Dong-quan/Kicad_BLDC_Motor/Doan2.step

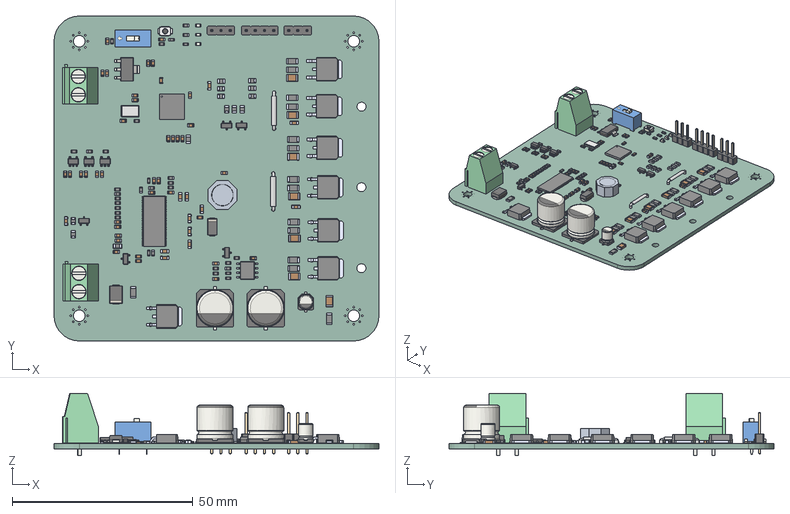
[picture p6: CAD file, 2026-10-30]
Doan2.step
90.0 x 90.0 x 17.3 mm
C_0805 x 12
IRFR7440PBF x 7
C_0603 x 38
R_1206 x 14
CP_Elec_4x5.4
R_0603 x 32
Crystal_4_5032
C_1206 x 7
R_0805 x 11
SOT-223
Bead_Ferrite_0805 x 2
SOT-23-3 x 5
SOT-23-5 x 3
L_8043
PinHeader_1x03_P2.54mm_Vertical x 2
TerminalBlock_Phoenix_MKDS-1,5-2-5.08_1x02_P5.08mm_Horizontal x 2
Shunt_1m x 2
CP_Elec_10x10.5 x 2
LED_0603_1608Metric x 3
STM32G431CBU6
SW_SPST_B3U-1000P
D_SMB
DRV8302DCA
MCP6002-I_SN
SW_DIP_SPSTx01_Slide_9.78x4.72mm_W7.62mm_P2.54mm
PinHeader_1x04_P2.54mm_Vertical
D_SMA
Doan2_PCB
