Dong-quan/Kicad_BLDC_Motor/Doan2.kicad_sch

## KiCad design Doan2.kicad_sch (2026-10-30)

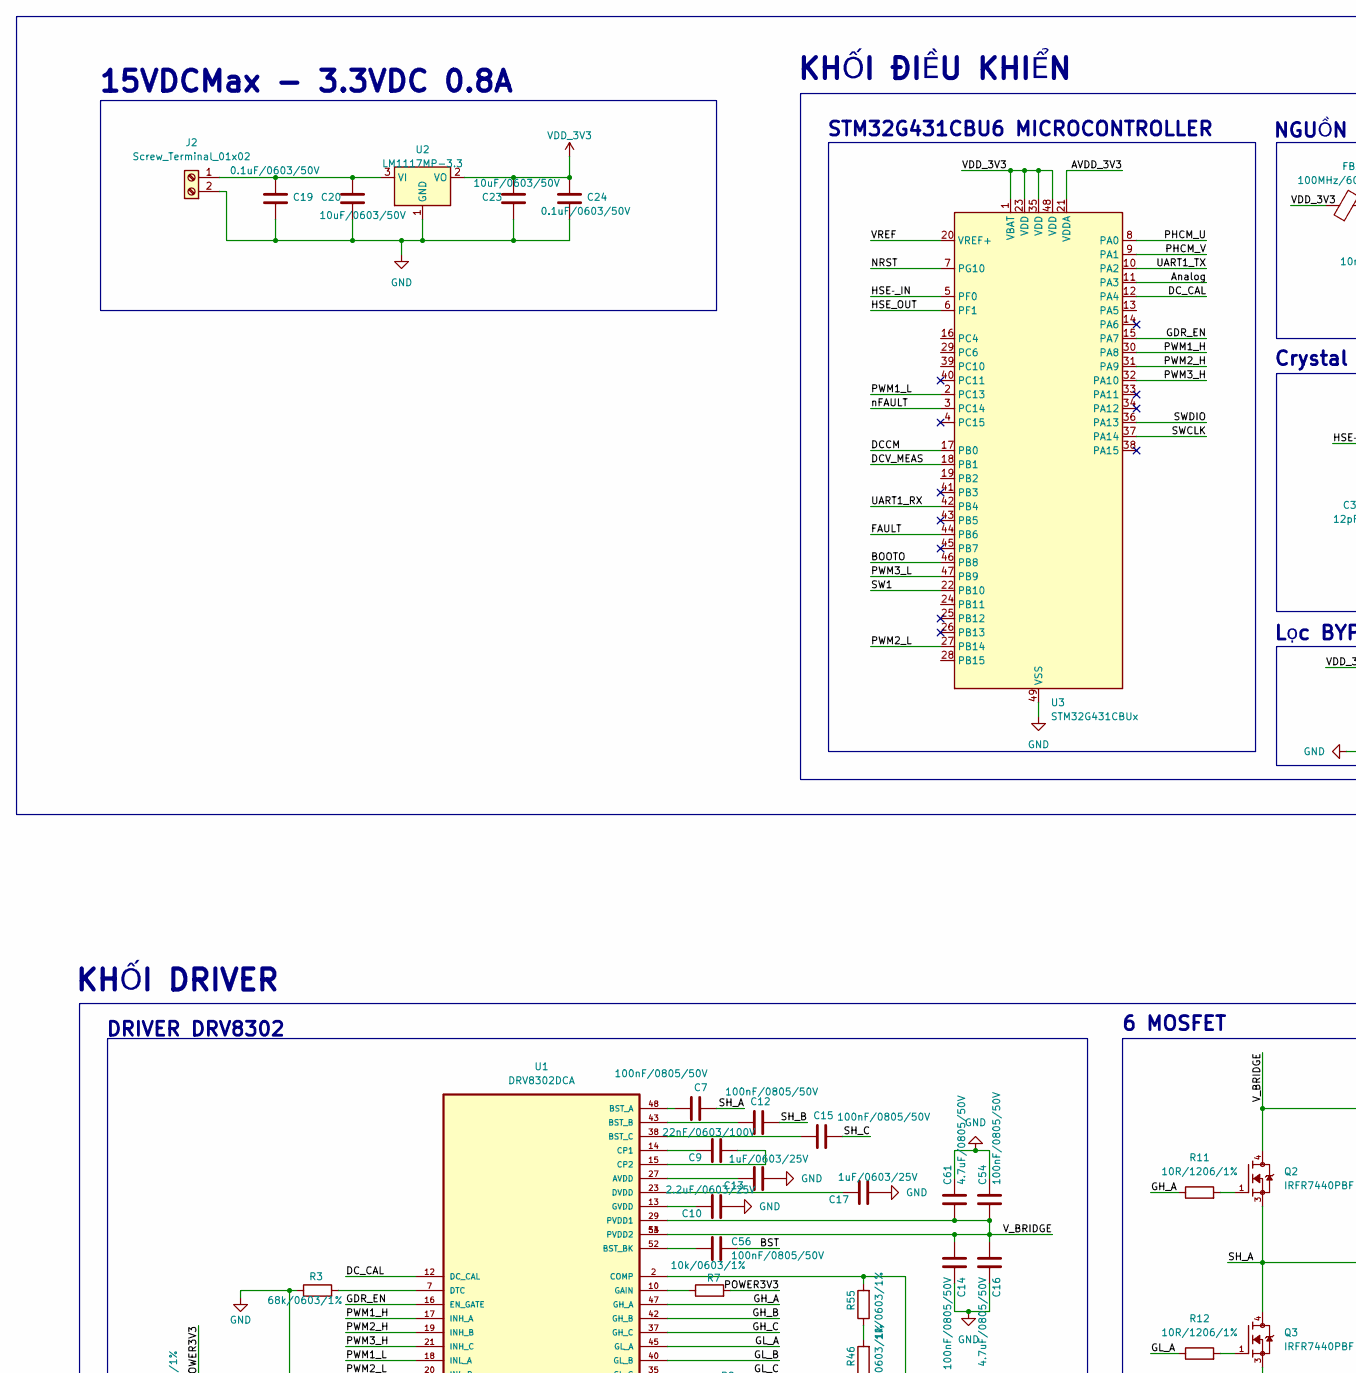
[picture p7: schematic Doan2.kicad_sch, part in row 1, column 1]

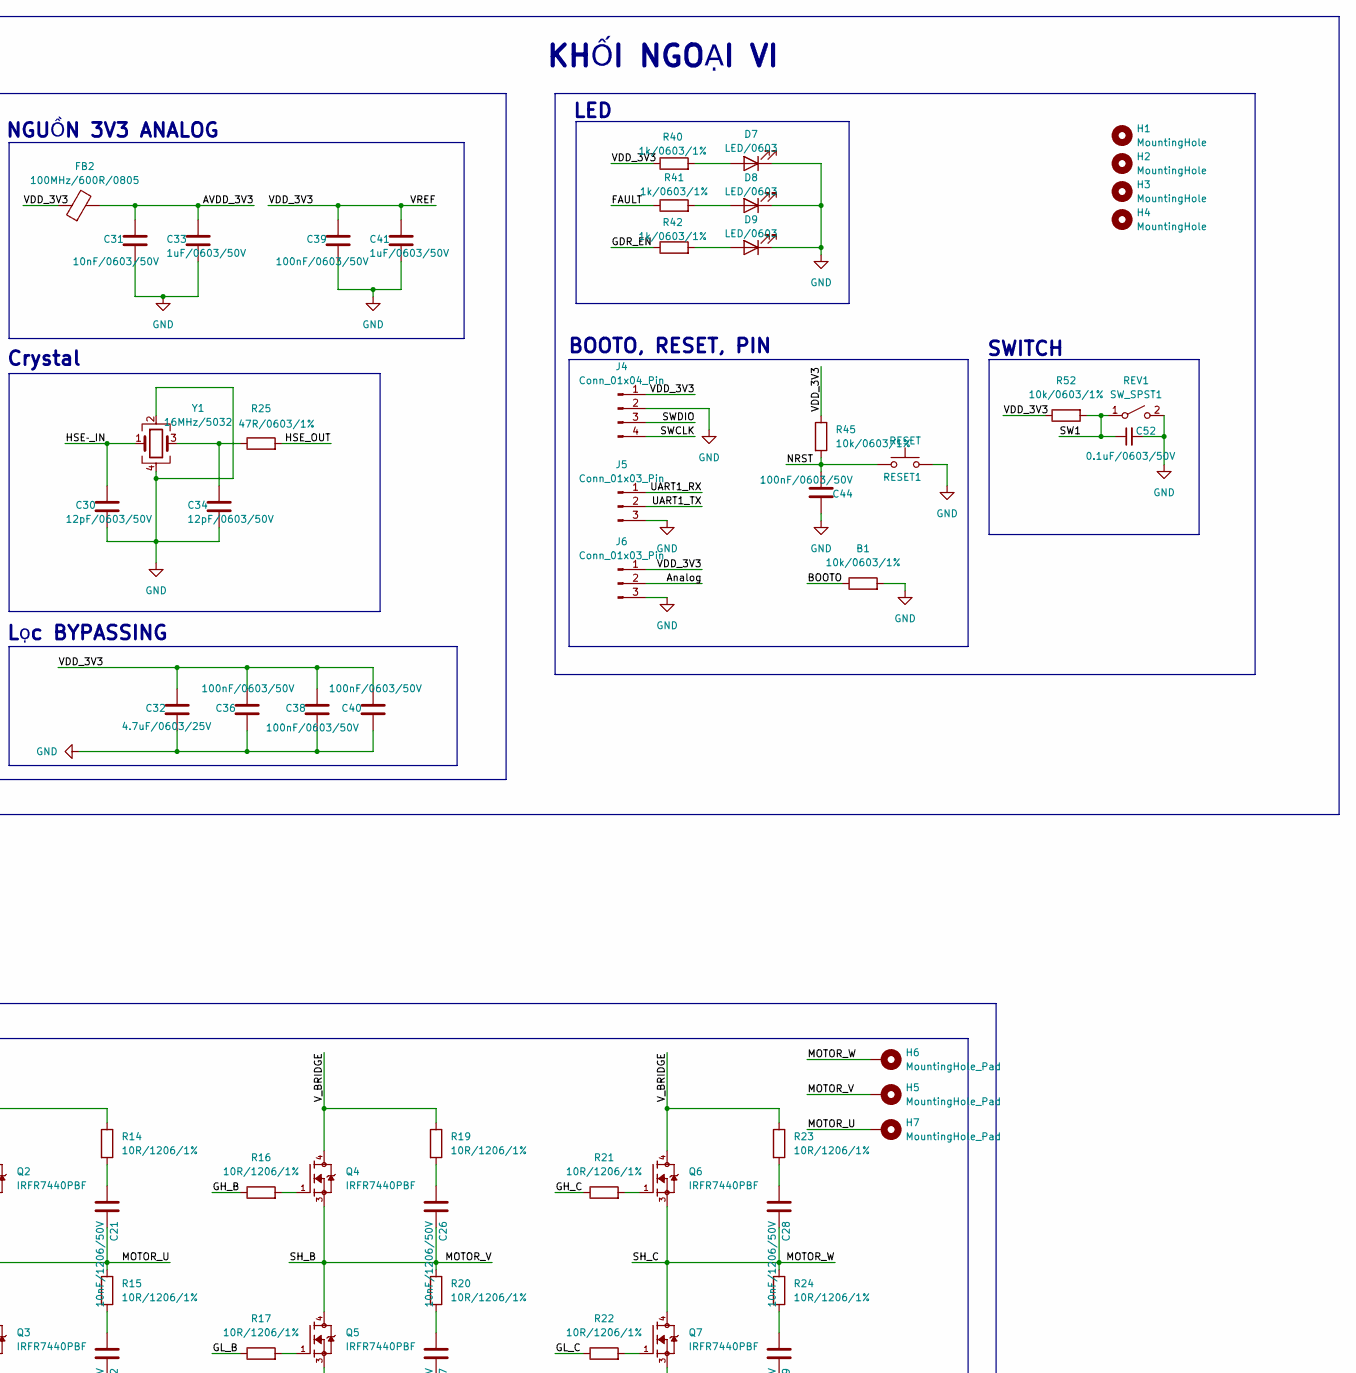
[picture p8: schematic Doan2.kicad_sch, part in row 1, column 2]

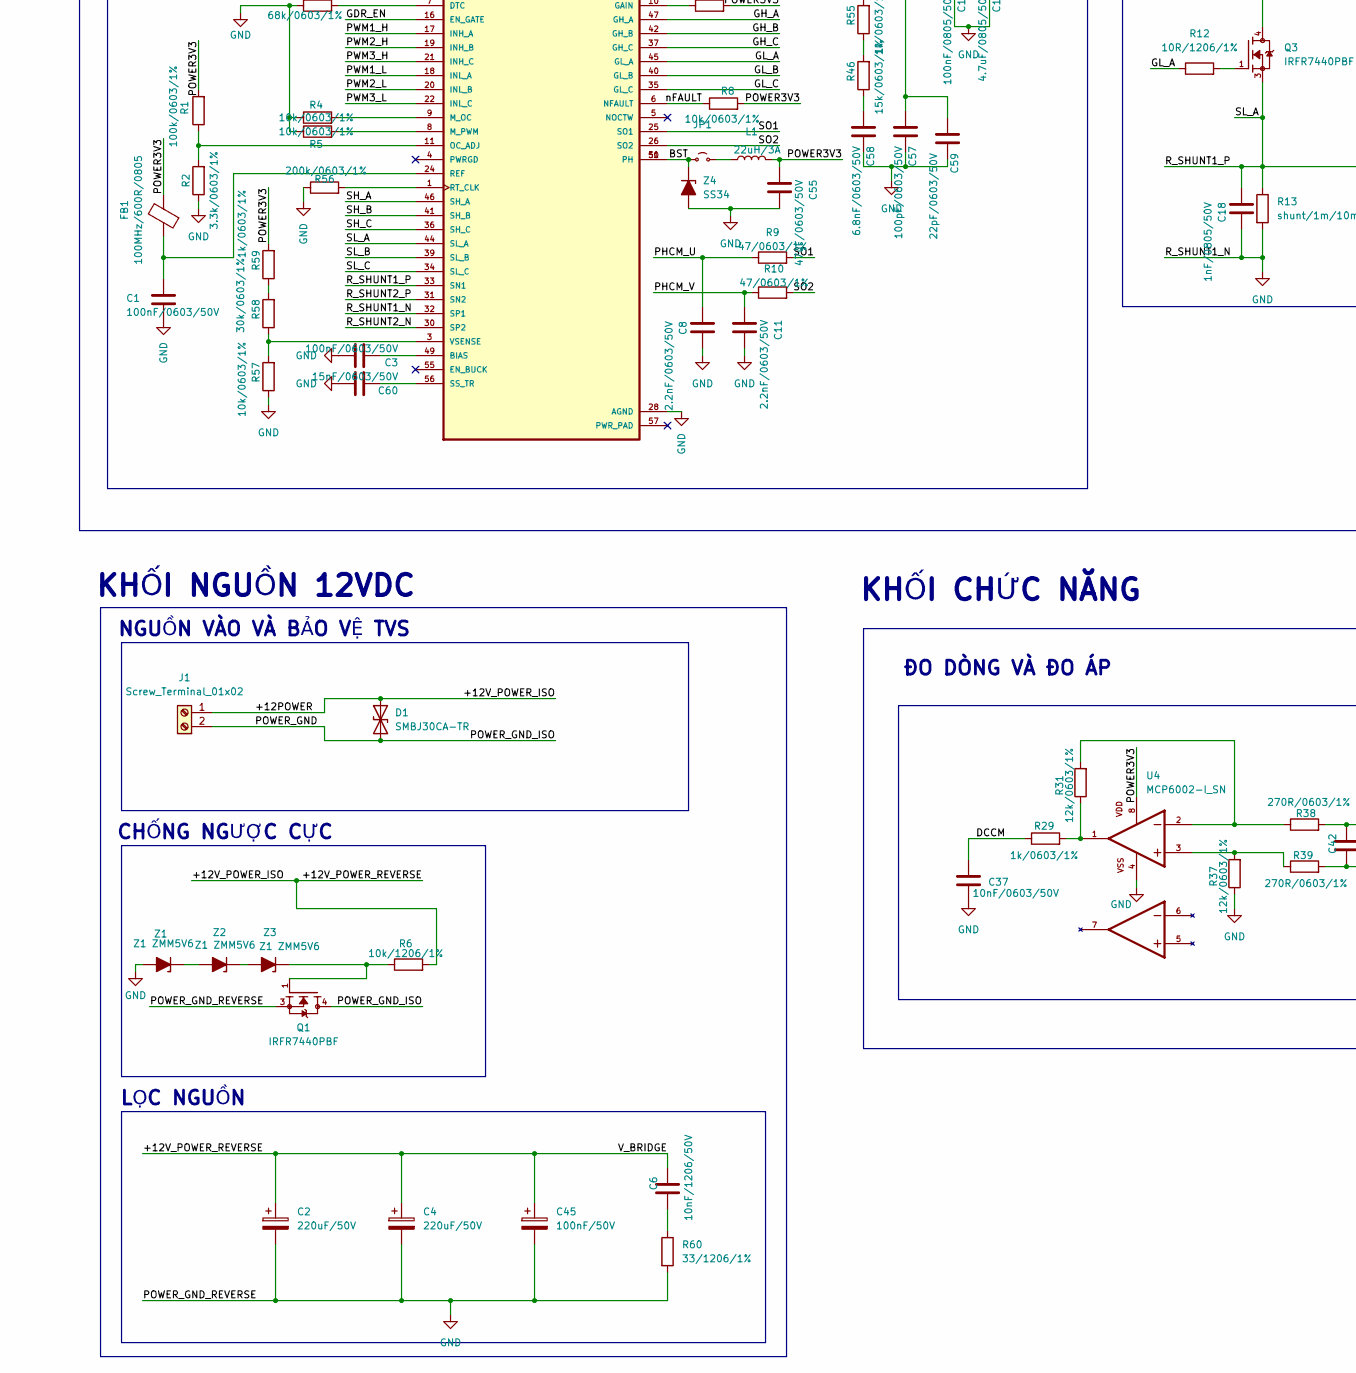
[picture p9: schematic Doan2.kicad_sch, part in row 2, column 1]

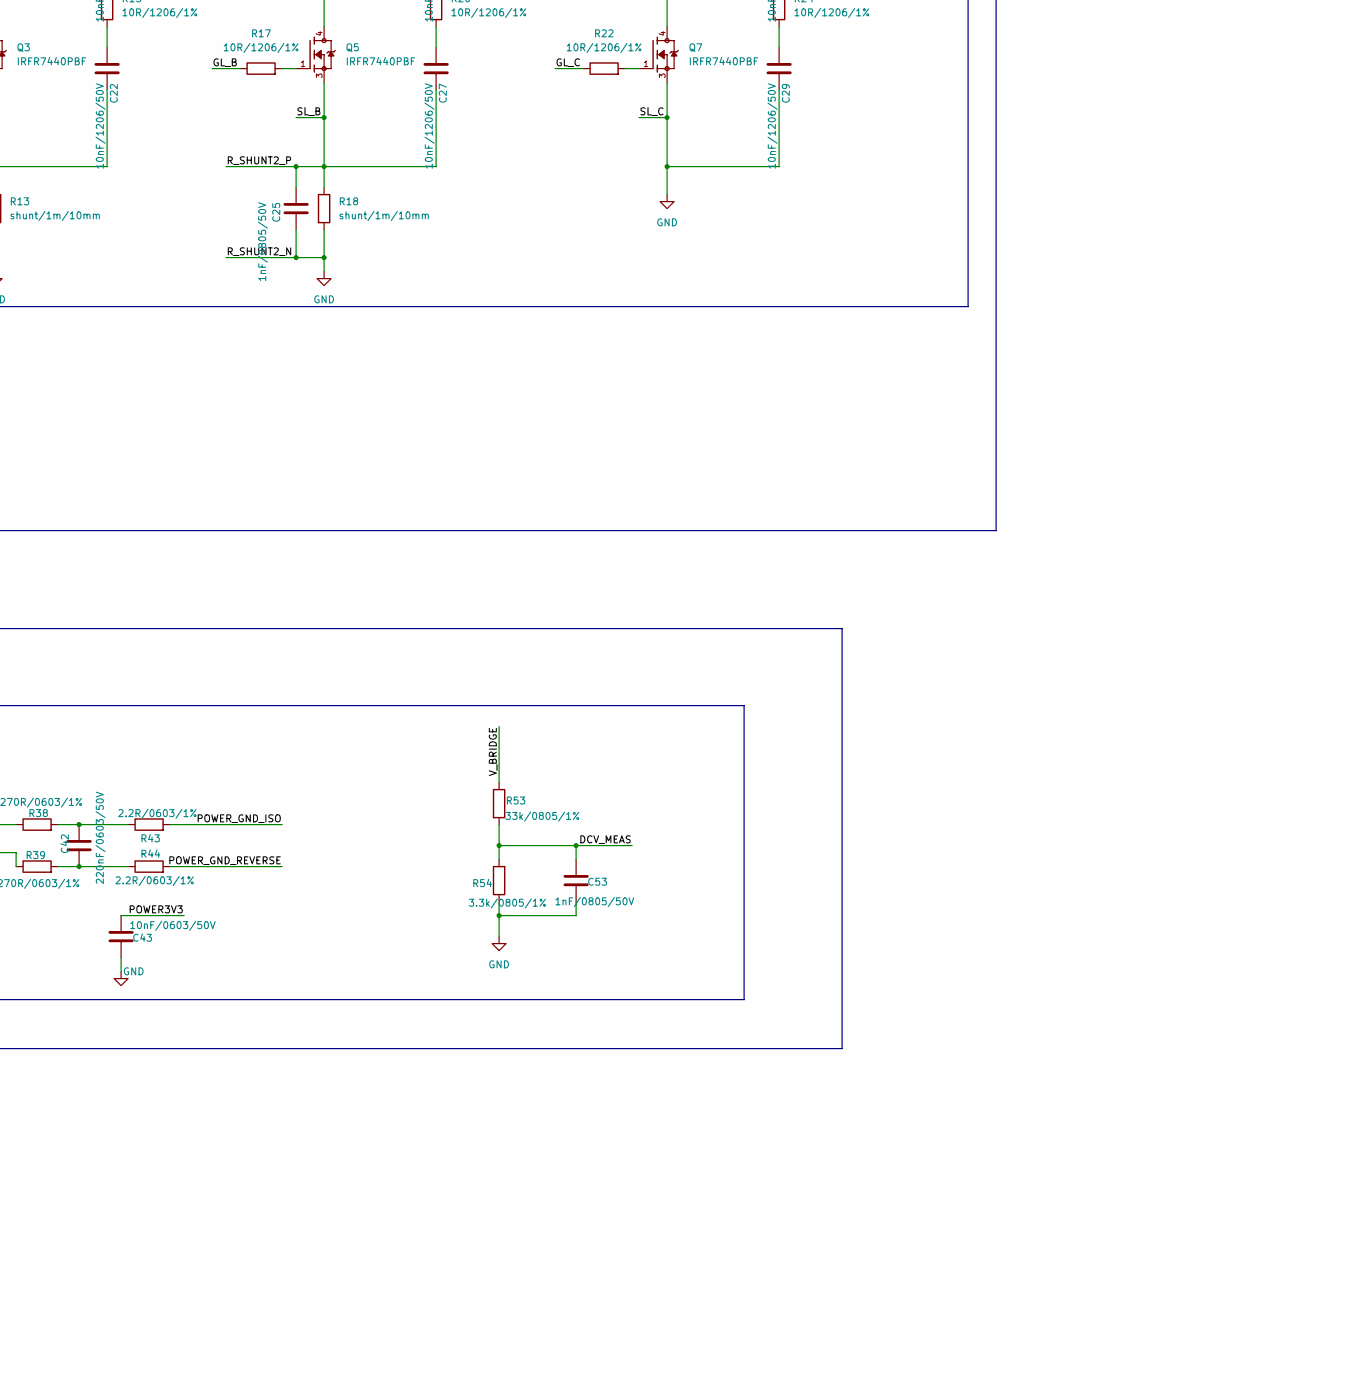
[picture p10: schematic Doan2.kicad_sch, part in row 2, column 2]

Parts:
B1: 10k/0603/1%; R_0603
C1, C3, C36, C38, C39, C40, C44: 100nF/0603/50V; C_0603
C2, C4: 220uF/50V; CP_Elec_10x10.5
C6, C21, C22, C26, C27, C28, C29: 10nF/1206/50V; C_1206
C7, C12, C14, C15, C54, C56: 100nF/0805/50V; C_0805
C8, C11: 2.2nF/0603/50V; C_0603
C9: 22nF/0603/100V; C_0603
C10: 2.2uF/0603/25V; C_0603
C13, C17: 1uF/0603/25V; C_0603
C16, C61: 4.7uF/0805/50V; C_0805
C18, C25, C53: 1nF/0805/50V; C_0805
C19, C24, C52: 0.1uF/0603/50V; C_0603
C20, C23: 10uF/0603/50V; C_0603
C30, C34: 12pF/0603/50V; C_0603
C31, C37, C43: 10nF/0603/50V; C_0603
C32: 4.7uF/0603/25V; C_0603
C33, C41: 1uF/0603/50V; C_0603
C42: 220nF/0603/50V; C_0603
C45: 100nF/50V; CP_Elec_4x5.4
C55: 47uF/0603/50V; C_0603
C57: 100pF/0603/50V; C_0603
C58: 6.8nF/0603/50V; C_0603
C59: 22pF/0603/50V; C_0603
C60: 15nF/0603/50V; C_0603
D1: SMBJ30CA-TR; D_SMB
D7, D8, D9: LED/0603; LED_0603_1608Metric
FB1, FB2: 100MHz/600R/0805; L_0805
H1, H2, H3, H4: MountingHole; MountingHole_3.2mm_M3_Pad_Via
H5, H6, H7: MountingHole_Pad; MountingHole_2.5mm_Pad_TopBottom
J1, J2: Screw_Terminal_01x02; TerminalBlock_Phoenix_MKDS-1,5-2-5.08_1x02_P5.08mm_Horizont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
J4: Conn_01x04_Pin; PinHeader_1x04_P2.54mm_Vertical
J5, J6: Conn_01x03_Pin; PinHeader_1x03_P2.54mm_Vertical
JP1: Jumper_2_Small_Open; SolderJumper-2_P1.3mm_Open_RoundedPad1.0x1.5mm
L1: 22uH/3A; L_8043
Q1, Q2, Q3, Q4, Q5, Q6, Q7: IRFR7440PBF; IRFR7440; PARTREV 2.4
R1: 100k/0603/1%; R_0603
R2: 3.3k/0603/1%; R_0603
R3: 68k/0603/1%; R_0603
R4, R5, R7, R8, R45, R52, R57: 10k/0603/1%; R_0603
R6: 10k/1206/1%; R_1206
R9, R10: 47/0603/1%; R_0603
R11, R12, R14, R15, R16, R17, R19, R20, R21, R22, R23, R24: 10R/1206/1%; R_1206
R13, R18: shunt/1m/10mm; Shunt_1m
R25: 47R/0603/1%; R_0603
R29, R40, R41, R42, R55, R59: 1k/0603/1%; R_0603
R31, R37: 12k/0603/1%; R_0603
R38, R39: 270R/0603/1%; R_0603
R43, R44: 2.2R/0603/1%; R_0603
R46: 15k/0603/1%; R_0603
R53: 33k/0805/1%; R_0805
R54: 3.3k/0805/1%; R_0805
R56: 200k/0603/1%; R_0603
R58: 30k/0603/1%; R_0603
R60: 33/1206/1%; R_1206
RESET1: RESET; SW_SPST_B3U-1000P
REV1: SW_SPST1; SW_DIP_SPSTx01_Slide_9.78x4.72mm_W7.62mm_P2.54mm
U1: DRV8302DCA
U2: LM1117MP-3.3; SOT-223-3_TabPin2
U3: STM32G431CBUx; STM32G431
U4: MCP6002-I_SN; MCP6002ISN; PARTREV L
Y1: 16MHz/5032; Crystal_SMD_5032-4Pin
Z1, Z2, Z3: Z1 ZMM5V6; zmm5v6
Z4: SS34; D_SMA

Connections:
+12POWER: C2.1, C4.1, C6.2, C14.2, C16.2, C45.1, C54.2, C61.2, D1.2 (A2), J1.1, Q2.4, Q4.4, Q6.4, R6.2, R14.1, R19.1, R23.1, R53.1, U1.29 (PVDD1), U1.53 (PVDD2), U1.54 (PVDD2)
AVDD_3V3: C31.1, C33.1, FB2.2, U3.21 (VDDA)
Analog: J6.2, U3.11 (PA3)
BOOTO: B1.1, U3.46 (PB8)
BST: C56.1, JP1.1 (A), U1.50 (PH), U1.51 (PH), Z4.1 (K)
DCCM: C37.2, R29.1, U3.17 (PB0)
DCV_MEAS: C53.2, R53.2, R54.2, U3.18 (PB1)
DC_CAL: U1.12 (DC_CAL), U3.12 (PA4)
FAULT: R41.1, U3.44 (PB6)
GDR_EN: R42.1, U1.16 (EN_GATE), U3.15 (PA7)
GH_A: R11.1, U1.47 (GH_A)
GH_B: R16.1, U1.42 (GH_B)
GH_C: R21.1, U1.37 (GH_C)
GL_A: R12.1, U1.45 (GL_A)
GL_B: R17.1, U1.40 (GL_B)
GL_C: R22.1, U1.35 (GL_C)
GND: B1.2, C1.1, C2.2, C3.1, C4.2, C8.1, C10.2, C11.1, C13.2, C14.1, C16.1, C17.2, C18.1, C19.2, C20.2, C23.2, C24.2, C25.1, C29.1, C30.2, C31.2, C32.2, C33.2, C34.2, C36.2, C37.1, C38.2, C39.2, C40.2, C41.2, C43.1, C44.1, C45.2, C52.2, C53.1, C54.1, C55.1, C57.1, C58.1, C59.1, C60.1, C61.1, D7.1 (K), D8.1 (K), D9.1 (K), J2.2, J4.2, J5.3, J6.3, Q1.3, Q7.3, R2.1, R3.1, R4.1, R5.1, R13.2, R18.2, R37.1, R44.2, R54.1, R56.1, R57.1, R60.2, RESET1.2, REV1.2 (B), U1.28 (AGND), U1.30 (SP2), U1.32 (SP1), U1.34 (SL_C), U2.1 (GND), U3.49 (VSS), U4.4, Y1.2, Y1.4, Z1.2 (A), Z4.2 (A)
HSE_OUT: R25.2, U3.6 (PF1)
HSE­_IN: C30.1, U3.5 (PF0), Y1.1
MOTOR_U: C7.2, C21.1, H7.1, Q2.3, Q3.4, R15.1, U1.46 (SH_A)
MOTOR_V: C12.2, C26.1, H5.1, Q4.3, Q5.4, R20.1, U1.41 (SH_B)
MOTOR_W: C15.2, C28.1, H6.1, Q6.3, Q7.4, R24.1, U1.36 (SH_C)
NRST: C44.2, R45.2, RESET1.1, U3.7 (PG10)
unnamed: C1.2, FB1.1, U1.24 (REF)
unnamed: C3.2, U1.49 (BIAS)
unnamed: C6.1, R60.1
unnamed: C7.1, U1.48 (BST_A)
unnamed: C9.1, U1.14 (CP1)
unnamed: C9.2, U1.15 (CP2)
unnamed: C10.1, U1.13 (GVDD)
unnamed: C12.1, U1.43 (BST_B)
unnamed: C13.1, U1.27 (AVDD)
unnamed: C15.1, U1.38 (BST_C)
unnamed: C17.1, U1.23 (DVDD)
unnamed: C19.1, C20.1, J2.1, U2.3 (VI)
unnamed: C21.2, R14.2
unnamed: C22.2, R15.2
unnamed: C26.2, R19.2
unnamed: C27.2, R20.2
unnamed: C28.2, R23.2
unnamed: C29.2, R24.2
unnamed: C34.1, R25.1, Y1.3
unnamed: C42.1, R39.2, R44.1
unnamed: C42.2, R38.2, R43.1
unnamed: C56.2, U1.52 (BST_BK)
unnamed: C57.2, C59.2, R55.2, U1.2 (COMP)
unnamed: C58.2, R46.1
unnamed: C60.2, U1.56 (SS_TR)
unnamed: D7.2 (A), R40.2
unnamed: D8.2 (A), R41.2
unnamed: D9.2 (A), R42.2
unnamed: JP1.2 (B), L1.1
unnamed: Q1.1, R6.1, Z3.1 (K)
unnamed: Q2.1, R11.2
unnamed: Q3.1, R12.2
unnamed: Q4.1, R16.2
unnamed: Q5.1, R17.2
unnamed: Q6.1, R21.2
unnamed: Q7.1, R22.2
unnamed: R1.1, R2.2, U1.11 (OC_ADJ)
unnamed: R3.2, U1.7 (DTC)
unnamed: R4.2, U1.9 (M_OC)
unnamed: R5.2, U1.8 (M_PWM)
unnamed: R7.1, U1.10 (GAIN)
unnamed: R29.2, R31.1, U4.1
unnamed: R31.2, R38.1, U4.2
unnamed: R37.2, R39.1, U4.3
unnamed: R46.2, R55.1
unnamed: R56.2, U1.1 (RT_CLK)
unnamed: R57.2, R58.1, U1.3 (VSENSE)
unnamed: R58.2, R59.1
unnamed: Z1.1 (K), Z2.2 (A)
unnamed: Z2.1 (K), Z3.2 (A)
PHCM_U: C8.2, R9.1, U3.8 (PA0)
PHCM_V: C11.2, R10.1, U3.9 (PA1)
POWER3V3: C43.2, C55.2, FB1.2, L1.2, R1.2, R7.2, R8.2, R59.2, U4.8
POWER_GND: D1.1 (A1), J1.2, Q1.4, R43.2
PWM1_H: U1.17 (INH_A), U3.30 (PA8)
PWM1_L: U1.18 (INL_A), U3.2 (PC13)
PWM2_H: U1.19 (INH_B), U3.31 (PA9)
PWM2_L: U1.20 (INL_B), U3.27 (PB14)
PWM3_H: U1.21 (INH_C), U3.32 (PA10)
PWM3_L: U1.22 (INL_C), U3.47 (PB9)
R_SHUNT1_P: C18.2, C22.1, Q3.3, R13.1, U1.33 (SN1), U1.44 (SL_A)
R_SHUNT2_P: C25.2, C27.1, Q5.3, R18.1, U1.31 (SN2), U1.39 (SL_B)
SO1: R9.2, U1.25 (SO1)
SO2: R10.2, U1.26 (SO2)
SW1: C52.1, R52.2, REV1.1 (A), U3.22 (PB10)
SWCLK: J4.4, U3.37 (PA14)
SWDIO: J4.3, U3.36 (PA13)
UART1_RX: J5.1, U3.42 (PB4)
UART1_TX: J5.2, U3.10 (PA2)
VDD_3V3: C23.1, C24.1, C32.1, C36.1, C38.1, C39.1, C40.1, C41.1, FB2.1, J4.1, J6.1, R40.1, R45.1, R52.1, U2.2 (VO), U3.1 (VBAT), U3.20 (VREF+), U3.23 (VDD), U3.35 (VDD), U3.48 (VDD)
nFAULT: R8.1, U1.6 (NFAULT), U3.3 (PC14)

Notes on the sheet:
KHỐI NGUỒN 12VDC
LED
KHỐI CHỨC NĂNG
NGUỒN 3V3 ANALOG
BOOTO, RESET, PIN
STM32G431CBU6 MICROCONTROLLER
CHỐNG NGƯỢC CỰC
6 MOSFET
15VDCMax - 3.3VDC 0.8A
Lọc BYPASSING
NGUỒN VÀO VÀ BẢO VỆ TVS
Crystal
KHỐI ĐIỀU KHIỂN
LỌC NGUỒN
ĐO DÒNG VÀ ĐO ÁP
KHỐI DRIVER
KHỐI NGOẠI VI
DRIVER DRV8302
SWITCH
